friosrhy/PAST_Onboarding/Onboarding Project Research.docx

Onboarding Project Research – Secondary Flight Storage

Background – Project Info

This project covers the creation of a secondary storage device used in a CubeSat to store non program data and to provide a space for any critical data that is yet to be transmitted or any data that is needed as part of the program but is too large to be kept in program memory all the time. This could include logs, photographs, and other telemetry data as well as being a buffer for data being transmitted. To test what sort of storage quantities would be needed, I performed some tests, creating a variety of sample images and text files, similar to those that would be stored on the, my 1920x1080 image came at 128KB with 50% quality JPEG compression, for my text file I got a sample log file out of some solidworks simulations which came out to about 2 KB. From this I determined that it would be ideal to have a storage size of about 256-512Mb and have 1Gb as a possible option in future.

Background – Requirements

For a device in low earth orbit, requirements include –

- Extremely careful software design and firmware design to ensure data integrity
- Storage that is resistant to radiation and damage by external stresses
- A microcontroller that will operate in a wide range on temperatures
- Careful power management ensuring the storage only uses power when absolutely necessary
- Maximum endurance to ensure data can be added and removed many times over a mission’s life cycle
- Signal integrity between MCU and storage module

Background – Storage Technologies

NAND vs NOR Flash -

NAND has a variety of advantages including better storage density and cost per unit storage allowing for large storage ICs at reasonable prices, it also has high read speeds when reading large files like videos. It is however slow for random reads and writes and it’s ability to change small amounts of data is limited as it has to erase an entire block to make any change to a given page, this means that it can wear out more quickly if files have to be modified often and can require extra complexity in software to ensure data integrity and in addition current draw is relatively high. NOR flash on the other hand is extremely fast for random writes and reads due to its different topology. It also is able to be directly executed from which can make it ideal as secondary program memory. It also has greater endurance due to being able to erase and write byte by byte. Current draw is also low compared to NAND. It is however more expensive per unit capacity and higher capacity ICs are just simply not available in many cases and it is slower when writing and reading sequentially. Due to the ideal minimum of around 512Mb, I have chosen a few different ICs with some different communication options such as SPI, QSPI, and Parallel to determine what would be ideal for this use case. I’ve chosen to look at 512Mb NOR Flash modules and 1Gb NAND modules.

Background – Available IC Options

NAND

Parallel 1Gb NAND (https://au.mouser.com/ProductDetail/Alliance-Memory/AS9F31G08SA-25BIN?qs=2SLPxufLcgAgAHU9zvz1dw%3D%3D)

Advantages:

- Similar low current draw to other NAND Package

Disadvantages:

- Hard to solder BGA package
- Needs more GPIOs

SPI 1Gb NAND (https://au.mouser.com/ProductDetail/GigaDevice/GD5F1GQ5UEYIHR?qs=81r%252BiQLm7BTva%252BKucqxC3g%3D%3D)

Advantages:

- Simplest overall package for easier layout
- Low current draw at 30mA
- Lower cost

Disadvantages:

- Less endurance than NOR options
- Higher standby current draw

NOR

Parallel 512Mb NOR (https://au.mouser.com/ProductDetail/Infineon-Technologies/S29GL512S11FHI010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)

Advantages:

- Higher 16 bit bus width
- Lower 60mA active read current

Disadvantages:

- Many GPIOs needed to control
- Costs more than similar SPI equivalent

SPI 512Mb NOR (https://au.mouser.com/ProductDetail/Infineon-Technologies/S25FL512SAGBHID10?qs=rDGpJoRV1kKM8aWD0nxfqg%3D%3D)

Advantages:

- Lower cost than parallel option
- Small footprint and simpler PCB layout

Disadvantages:

- Smaller bus width
- Higher 90mA active read current

Overall Selection

SPI has been chosen as it avoids significant GPIO wastage and is easier to program, the decision between NAND and NOR is simply based on the required endurance, cost, and capacity, given our low capacity requirements and a generally low cost across the board, and the low power consumption environment it will be running in, I have chosen to use an SPI NOR package with a capacity of 512Mb.

The chosen package is the Infineon S25HL512TDPNHI010 (https://au.mouser.com/ProductDetail/Infineon-Technologies/S25HL512TDPNHI010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) due to it’s combination of compact package, easy PCB routing, decent active power draw at 40mA and low cost in comparison to other options.

Background – MCU Selection

To choose an MCU, I had a few main criteria –

- Low idle power consumption
- Easy PCB integration (minimal external components needed)
- Easy programming with both MicroPython and C++ options available.
- Good documentation and datasheet.

From these criteria I have looked at a few different families of microcontrollers including the ESP32, RP2040 and 2350, and the STM32, when looking into these different microcontrollers, the ESP32-WROOM modules stood out due to their easy to use design, having a variety of needed parts built in such as USB to serial conversion and flash memory for the program being run, this however made them more expensive than alternative options, the RP family from raspberry pi stood out for its fantastic documentation including minimal reference designs and PCB layout examples. Finally, the STM32 family from STMicroelectronics was desirable due to its heavy use in industry and variety of options to choose from. In the end to simplify the design overall I chose to use an ESP32-S3-WROOM-1U (https://au.mouser.com/ProductDetail/Espressif-Systems/ESP32-S3-WROOM-1U-N16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) due to its built in USB to serial converter, flash memory and easy to route footprint.

References

Denholm, T. (2024). Cube satellites – small in size with big flash memory constraints. [online] Tuxera. Available at: Cube satellites – small in size with big flash memory constraints [Accessed 24 Mar. 2026].

Chang, C. (n.d.). SSD Challenges in Low-Earth-Orbit (LEO) Applications. [online] Available at: https://files.futurememorystorage.com/proceedings/2024/20240806_AOSD-103-1_Chang.pdf [Accessed 24 Mar. 2026].

‌Kingston Technology Company. (n.d.). Difference between SLC, MLC, TLC and 3D NAND in USB flash drives, SSDs and memory cards. [online] Available at: https://www.kingston.com/en/blog/pc-performance/difference-between-slc-mlc-tlc-3d-nand.

‌GeeksforGeeks (2024). Differences Between NAND vs NOR Flash Memory. [online] GeeksforGeeks. Available at: https://www.geeksforgeeks.org/electronics-engineering/differences-between-nand-vs-nor-flash-memory/.

‌
