friosrhy/PAST_Onboarding/PCB Design/Secondary_Flight_Storage_KiCAD/Part Libraries/3D_Models/USB4520-03-0-A_REVA.step

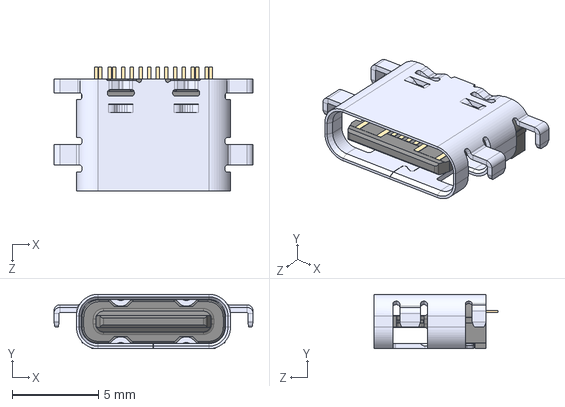
[picture p1: CAD file, 2026-05-16]
PCB Design/Secondary_Flight_Storage_KiCAD/Part Libraries/3D_Models/USB4520-03-0-A_REVA.step
11.5 x 3.16 x 7.20 mm
