friosrhy/PAST_Onboarding/PCB Design/Secondary_Flight_Storage_KiCAD/Secondary_Flight_Storage_Case_Bottom.STEP

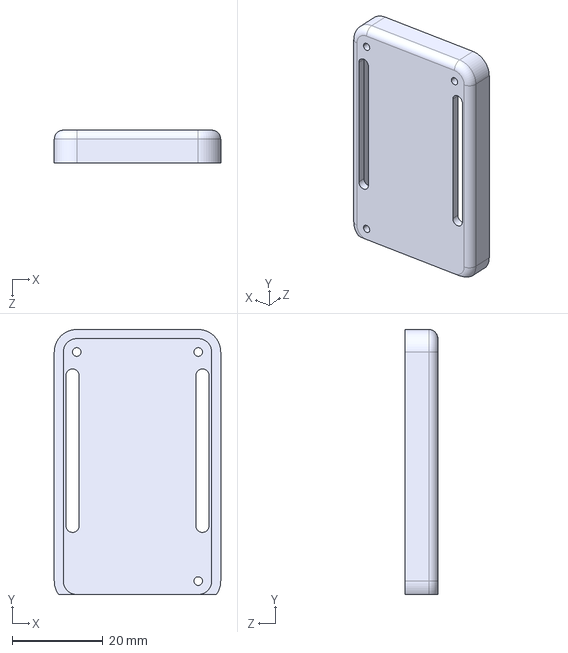
[picture p2: CAD file, 2026-05-16]
PCB Design/Secondary_Flight_Storage_KiCAD/Secondary_Flight_Storage_Case_Bottom.STEP
36.6 x 58.3 x 7.20 mm
