friosrhy/PAST_Onboarding/PCB Design/Secondary_Flight_Storage_KiCAD/Part Libraries/3D_Models/S25HL512TDPNHI010.step

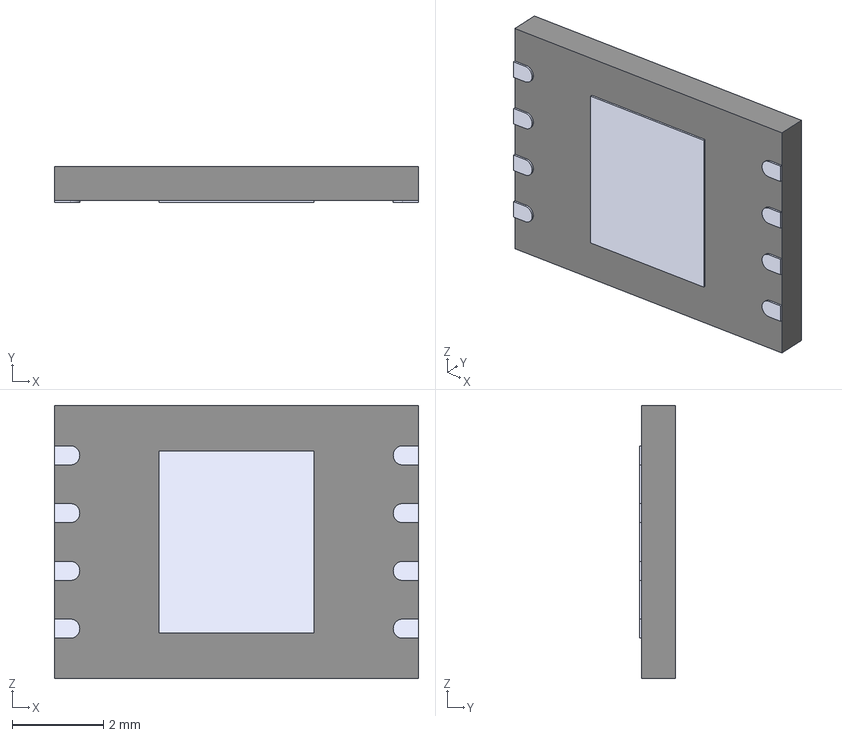
[picture p3: CAD file, 2026-05-16]
PCB Design/Secondary_Flight_Storage_KiCAD/Part Libraries/3D_Models/S25HL512TDPNHI010.step
8.00 x 0.8 x 6.00 mm
BaseWithTopCut
TopCircle_NewBody
