friosrhy/PAST_Onboarding/PCB Design/Secondary_Flight_Storage_KiCAD/Secondary_Flight_Storage_Case_Top.STEP

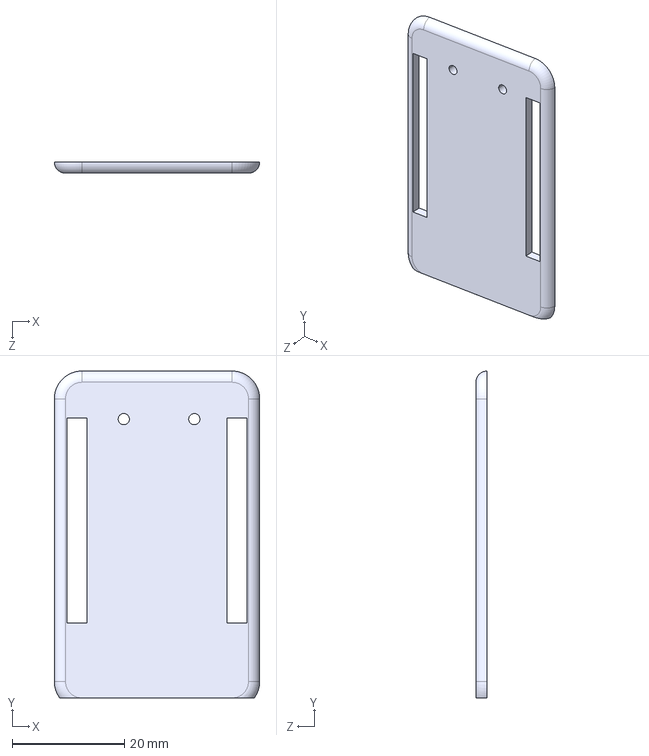
[picture p4: CAD file, 2026-05-16]
PCB Design/Secondary_Flight_Storage_KiCAD/Secondary_Flight_Storage_Case_Top.STEP
36.6 x 58.3 x 2.00 mm
