friosrhy/PAST_Onboarding/PCB Design/Secondary_Flight_Storage_KiCAD/Part Libraries/3D_Models/2659--3DModel-STEP-56544.STEP

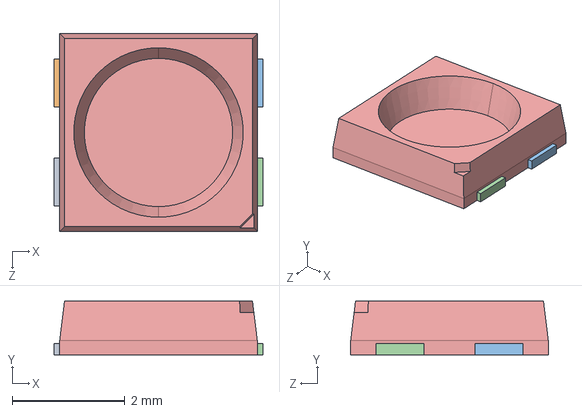
[picture p5: CAD file, 2026-05-16]
PCB Design/Secondary_Flight_Storage_KiCAD/Part Libraries/3D_Models/2659--3DModel-STEP-56544.STEP
3.70 x 0.95 x 3.50 mm
