friosrhy/PAST_Onboarding/PCB Design/Secondary_Flight_Storage_V2/Secondary_Flight_Storage_V2.pdf

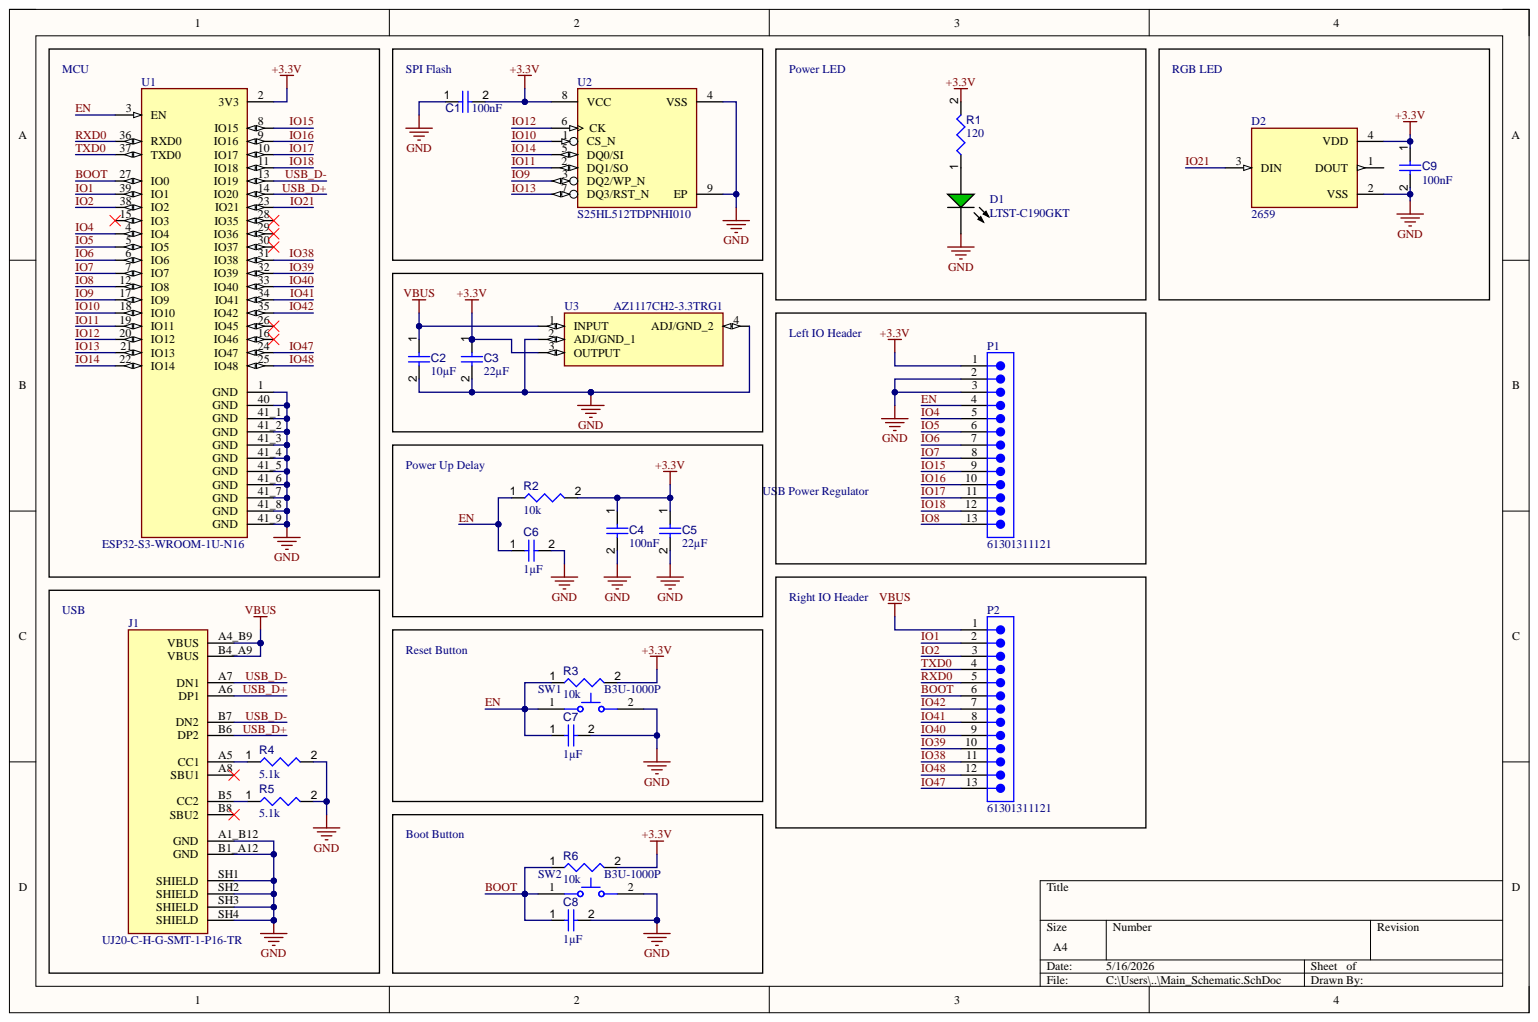
[picture p6: page 1]

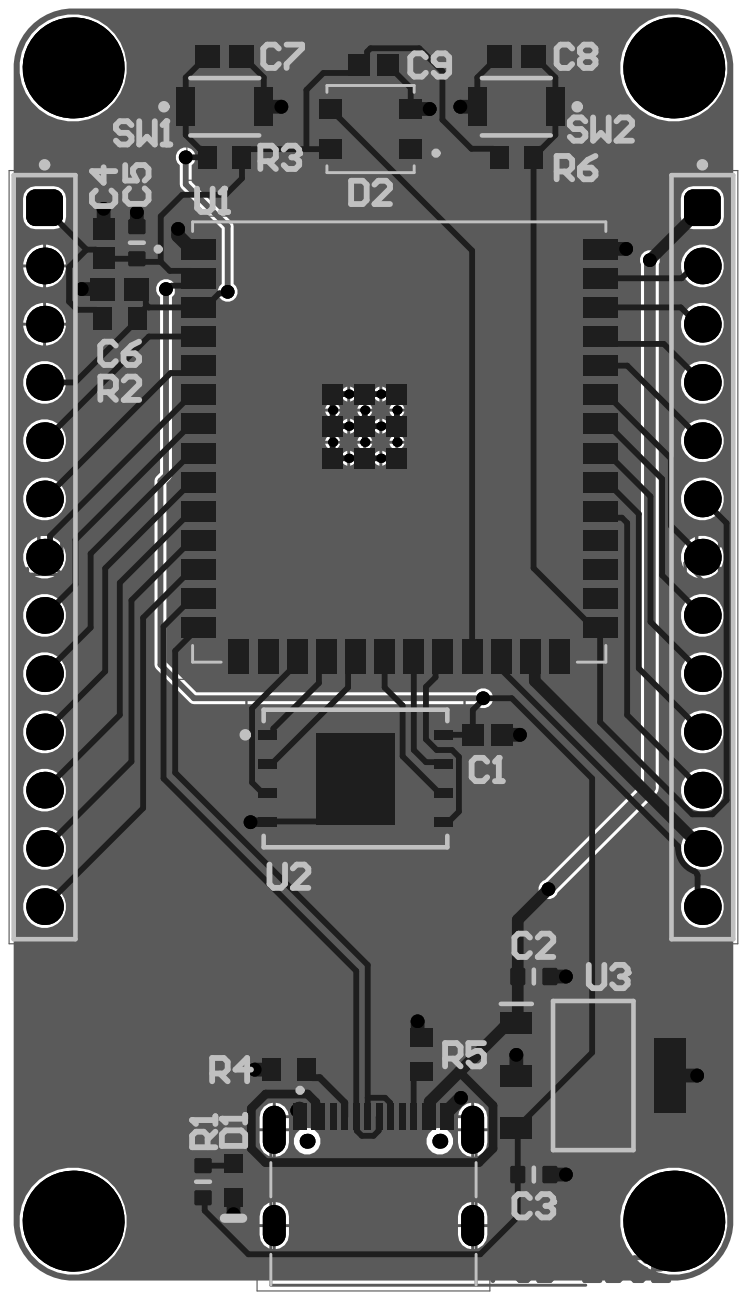
[picture p7: page 2]
