friosrhy/PAST_Onboarding/(list of files, drawings)

Other design files:
PCB Design/Secondary_Flight_Storage_V2/Main_Layout.PcbDoc
PCB Design/Secondary_Flight_Storage_V2/Main_Schematic.SchDoc
PCB Design/Secondary_Flight_Storage_V2/Secondary_Flight_Storage_V2.PrjPcb
