friosrhy/PAST_Onboarding/PCB Design/Secondary_Flight_Storage_KiCAD/Secondary_Flight_Storage.kicad_pcb

## KiCad design PCB Design/Secondary_Flight_Storage_KiCAD/Secondary_Flight_Storage.kicad_pcb (2026-05-16)

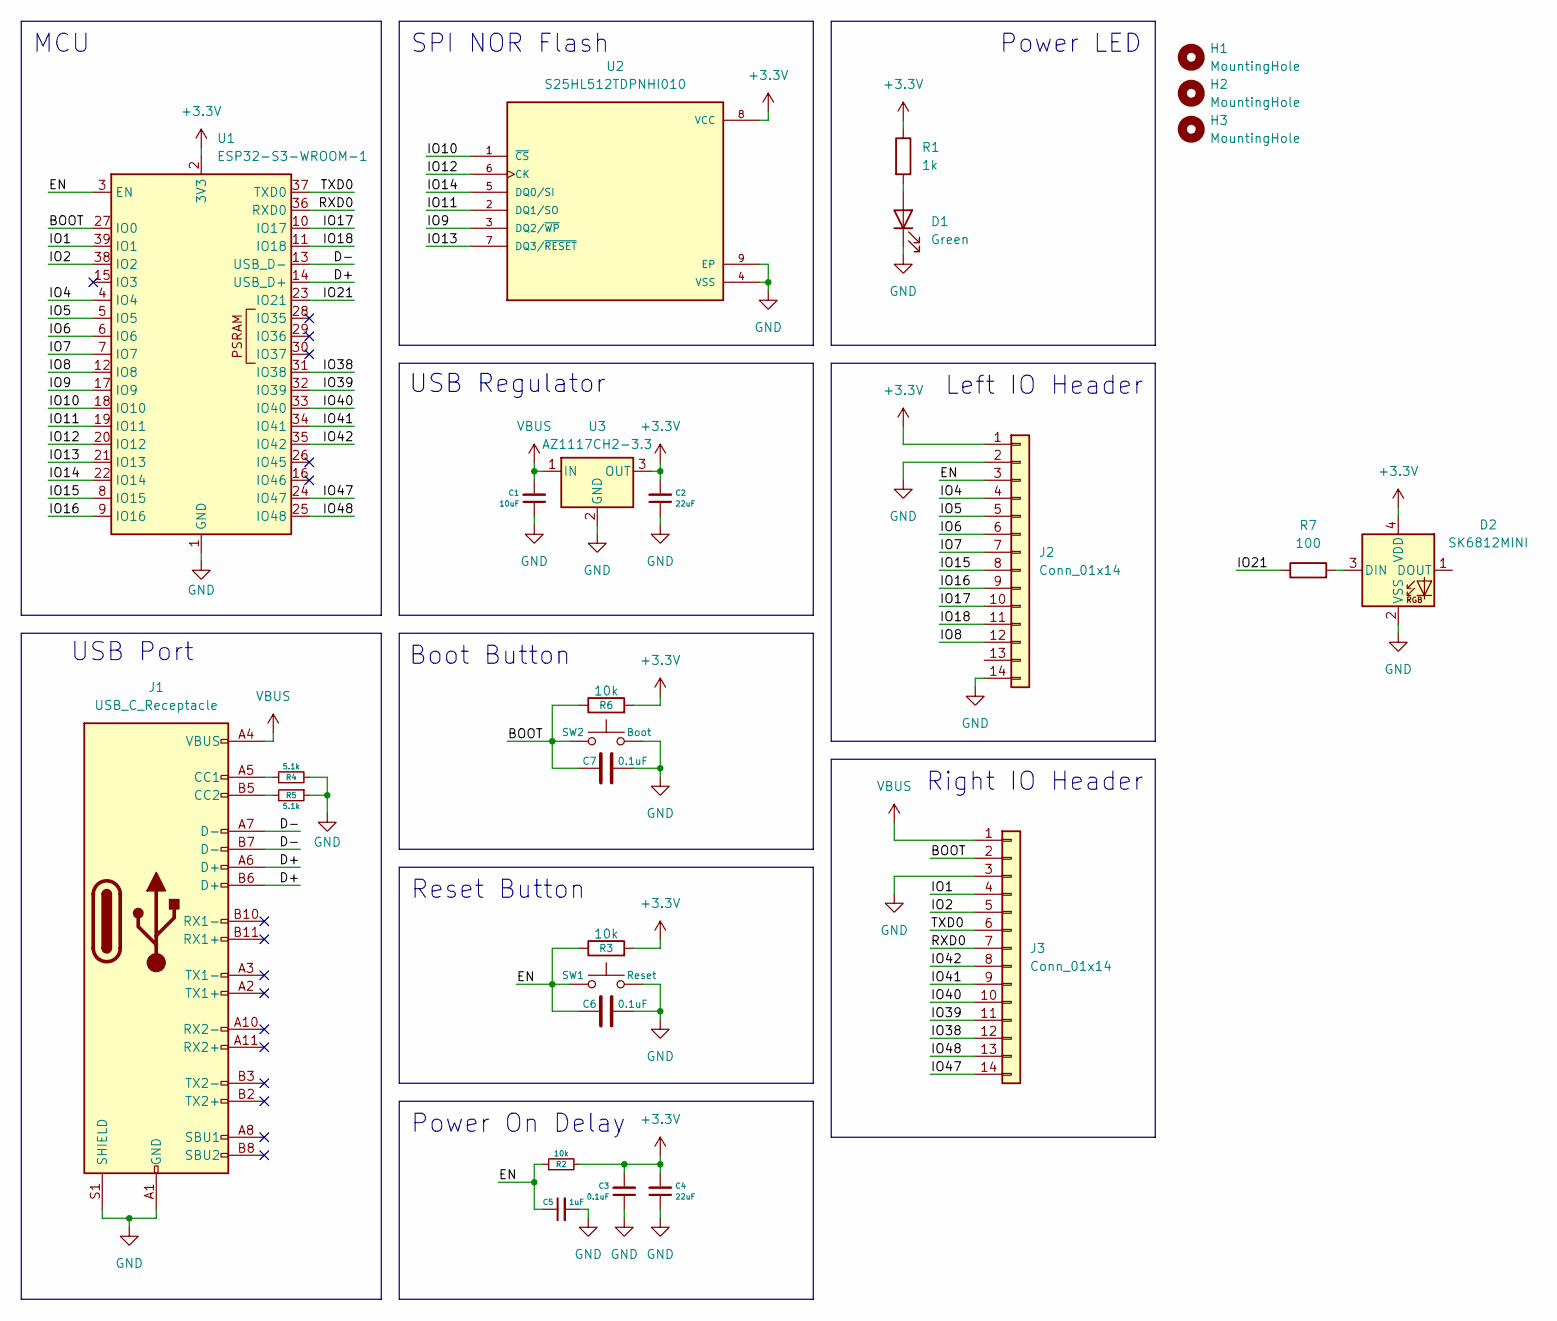
[picture p8: schematic Secondary_Flight_Storage.kicad_sch]

Parts:
C1: 10uF; C_0603_1608Metric_Pad1.08x0.95mm_HandSolder
C2, C4: 22uF; C_0603_1608Metric_Pad1.08x0.95mm_HandSolder
C3, C6, C7: 0.1uF; C_0603_1608Metric_Pad1.08x0.95mm_HandSolder
C5: 1uF; C_0603_1608Metric_Pad1.08x0.95mm_HandSolder
D1: Green; LED_0603_1608Metric_Pad1.05x0.95mm_HandSolder
D2: SK6812MINI; LED_SK6812MINI_PLCC4_3.5x3.5mm_P1.75mm
H1, H2, H3: MountingHole; MountingHole_2.2mm_M2
J1: USB_C_Receptacle; USB_C_Receptacle_GCT_USB4105-xx-A_16P_TopMnt_Horizontal
J2, J3: Conn_01x14; PinHeader_1x14_P2.54mm_Vertical
R1: 1k; R_0603_1608Metric_Pad0.98x0.95mm_HandSolder
R2, R3, R6: 10k; R_0603_1608Metric_Pad0.98x0.95mm_HandSolder
R4, R5: 5.1k; R_0603_1608Metric_Pad0.98x0.95mm_HandSolder
R7: 100; R_0603_1608Metric_Pad0.98x0.95mm_HandSolder
SW1: Reset; SW_SPST_B3U-1000P
SW2: Boot; SW_SPST_B3U-1000P
U1: ESP32-S3-WROOM-1; ESP32-S3-WROOM-1U
U2: S25HL512TDPNHI010; SON127P600X800X80-9N; PARTREV AB; DigiKey_Part_Number 448-S25HL512TDPNHI010-ND
U3: AZ1117CH2-3.3; SOT-223-3_TabPin2

Connections:
+3.3V: C2.2, C3.2, C4.2, D2.4 (VDD), J2.1, R1.1, R2.2, R3.2, R6.2, U1.2 (3V3), U2.8 (VCC), U3.3 (OUT)
/BOOT: C7.1, J3.2, R6.1, SW2.1, U1.27 (IO0)
/D+: J1.A6 (D+), J1.B6 (D+), U1.14 (USB_D+)
/D-: J1.A7 (D-), J1.B7 (D-), U1.13 (USB_D-)
/EN: C5.1, C6.1, J2.3, R2.1, R3.1, SW1.1, U1.3 (EN)
/IO1: J3.4, U1.39 (IO1)
/IO2: J3.5, U1.38 (IO2)
/IO4: J2.4, U1.4 (IO4)
/IO5: J2.5, U1.5 (IO5)
/IO6: J2.6, U1.6 (IO6)
/IO7: J2.7, U1.7 (IO7)
/IO8: J2.12, U1.12 (IO8)
/IO9: U1.17 (IO9), U2.3 (DQ2/~WP)
/IO10: U1.18 (IO10), U2.1 (~CS)
/IO11: U1.19 (IO11), U2.2 (DQ1/SO)
/IO12: U1.20 (IO12), U2.6 (CK)
/IO13: U1.21 (IO13), U2.7 (DQ3/~RESET)
/IO14: U1.22 (IO14), U2.5 (DQ0/SI)
/IO15: J2.8, U1.8 (IO15)
/IO16: J2.9, U1.9 (IO16)
/IO17: J2.10, U1.10 (IO17)
/IO18: J2.11, U1.11 (IO18)
/IO21: R7.1, U1.23 (IO21)
/IO38: J3.12, U1.31 (IO38)
/IO39: J3.11, U1.32 (IO39)
/IO40: J3.10, U1.33 (IO40)
/IO41: J3.9, U1.34 (IO41)
/IO42: J3.8, U1.35 (IO42)
/IO47: J3.14, U1.24 (IO47)
/IO48: J3.13, U1.25 (IO48)
/RXD0: J3.7, U1.36 (RXD0)
/TXD0: J3.6, U1.37 (TXD0)
GND: C1.1, C2.1, C3.1, C4.1, C5.2, C6.2, C7.2, D1.1 (K), D2.2 (VSS), J1.A1 (GND), J1.A12 (GND), J1.B1 (GND), J1.B12 (GND), J1.S1 (SHIELD), J2.2, J2.14, J3.3, R4.2, R5.1, SW1.2, SW2.2, U1.1 (GND), U1.40 (GND), U1.41 (GND), U2.4 (VSS), U2.9 (EP), U3.2 (GND)
unnamed: D1.2 (A), R1.2
unnamed: D2.3 (DIN), R7.2
unnamed: J1.A5 (CC1), R4.1
unnamed: J1.B5 (CC2), R5.2
VBUS: C1.2, J1.A4 (VBUS), J1.A9 (VBUS), J1.B4 (VBUS), J1.B9 (VBUS), J3.1, U3.1 (IN)

Notes on the sheet:
USB Regulator
Right IO Header
Boot Button
Reset Button
Left IO Header
Power On Delay
USB Port
MCU
SPI NOR Flash
Power LED

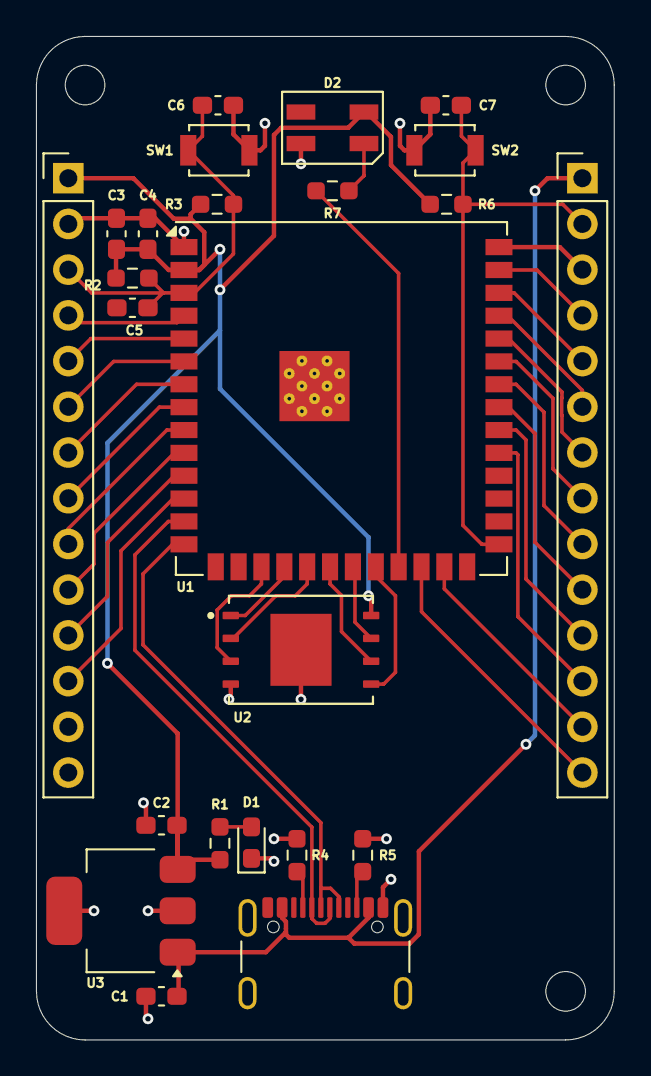
[picture p9: board Secondary_Flight_Storage.kicad_pcb from above]

Board: 2 copper layers, 32.1 x 55.8 mm, 27 parts (0 on the bottom side), 38 nets.
