friosrhy/PAST_Onboarding/(commit log)

2026-03-28 Added PCB project files and research document, updated logbook
    [Secondary_Flight_Storage.PrjPcb, Secondary_Flight_Storage.SchDoc]
2026-04-04 Updated logbook and began work on schematic
    [ESP32-S3-WROOM-1U-N16R8.SchLib, MountingPin.SchLib, Secondary_Flight_Storage.PrjPcb, Secondary_Flight_Storage.SchDoc, XCVR_ESP32-S3-WROOM-1U-N16R8.PcbLib]
2026-04-21 Added V2 PCB Design and updated logbook
    [ESP32-S3-WROOM-1U-N16R8.SchLib, Main_Layout.PcbDoc, Main_Schematic.SchDoc, Secondary_Flight_Storage.SchDoc, Secondary_Flight_Storage_V2.PrjPcb, XCVR_ESP32-S3-WROOM-1U-N16R8.PcbLib]
2026-05-06 Updated logbook and PCB designs
    [Main_Layout.PcbDoc, Main_Schematic.SchDoc]
2026-05-16 Final Commit: Finalised PCB design, updated logbook, and finished logbook design
    [2659--3DModel-STEP-56544.STEP, IMU Board.kicad_pcb, IMU Board.kicad_sch, Main_Layout.PcbDoc, Main_Schematic.SchDoc, MountingPin.SchLib, S25HL512TDPNHI010.step, Secondary_Flight_Storage.PrjPcb]
